tomcircuit/hp10544-retrofit/media/installed.JPG

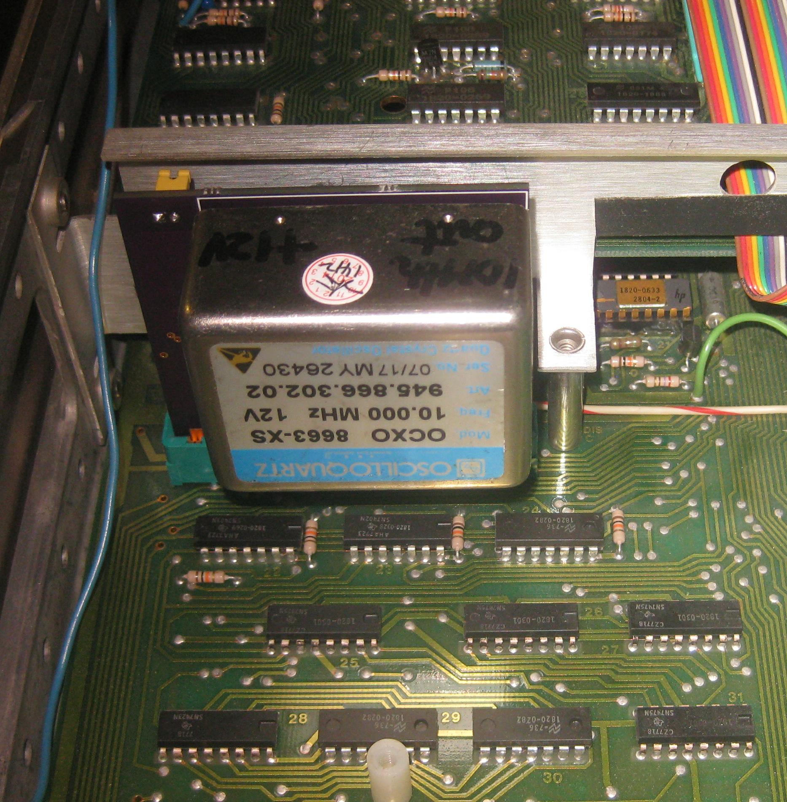
media/installed.JPG
