tomcircuit/hp10544-retrofit/media/installed rear.JPG

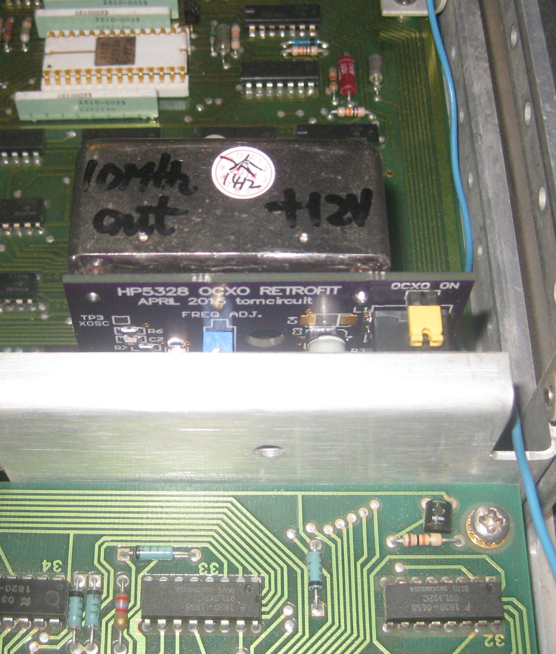
media/installed rear.JPG
