tomcircuit/hp10544-retrofit/media/front view.JPG

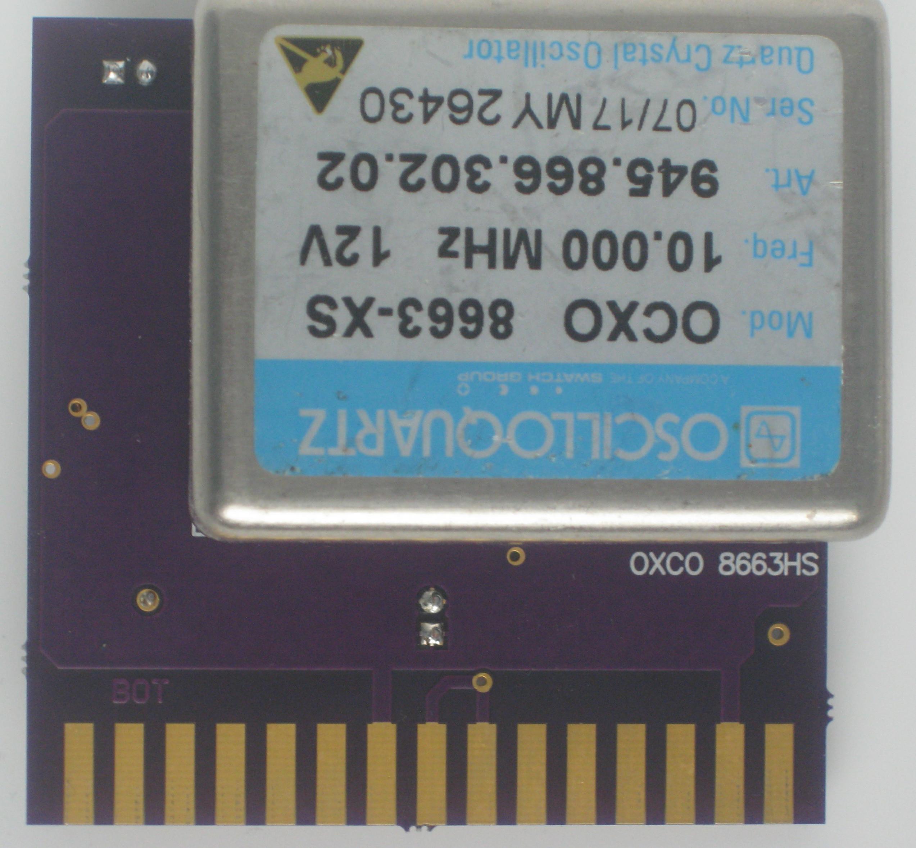
media/front view.JPG
