tomcircuit/hp10544-retrofit/media/hp5328 OCXO bay.JPG

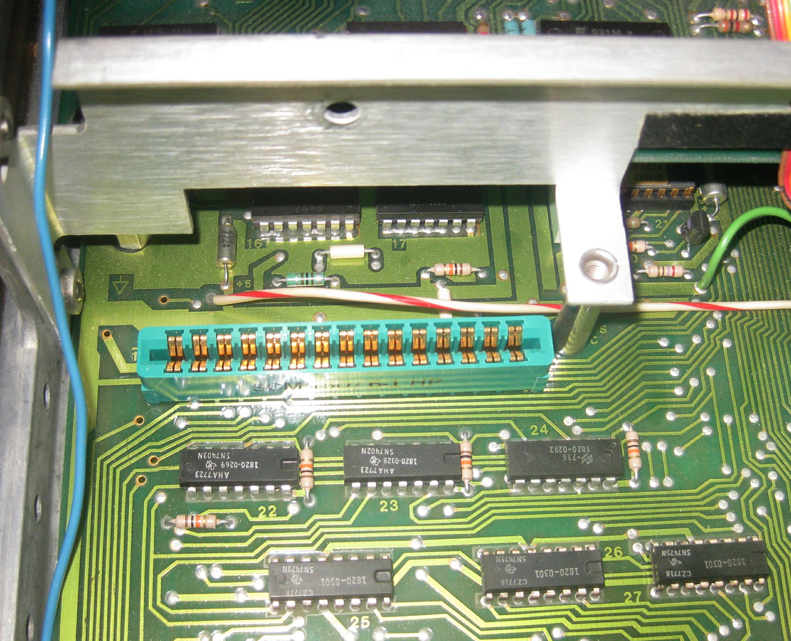
media/hp5328 OCXO bay.JPG
