tomcircuit/hp10544-retrofit/media/isntalled front.JPG

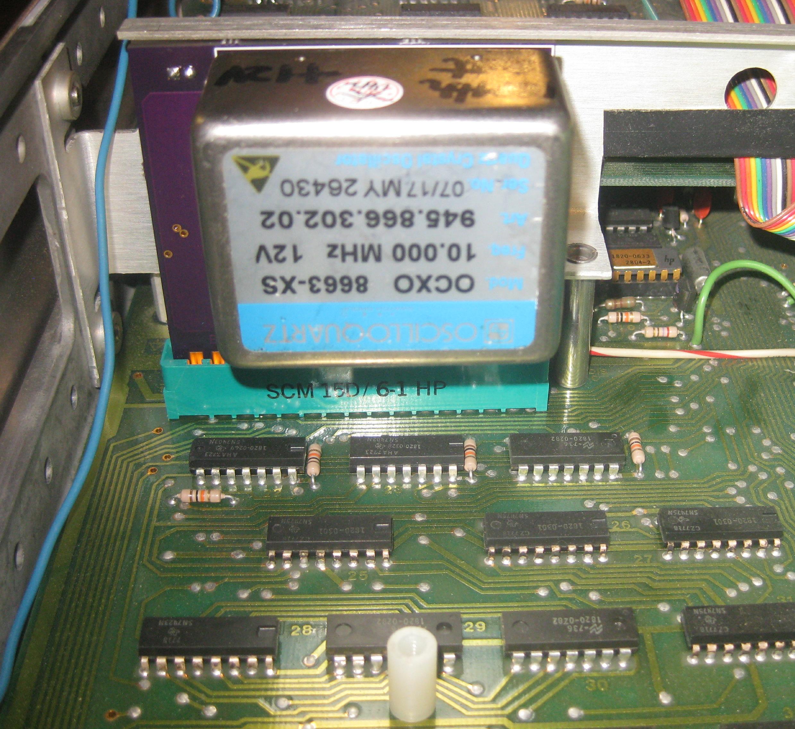
media/isntalled front.JPG
