tomcircuit/hp10544-retrofit/media/rear view.JPG

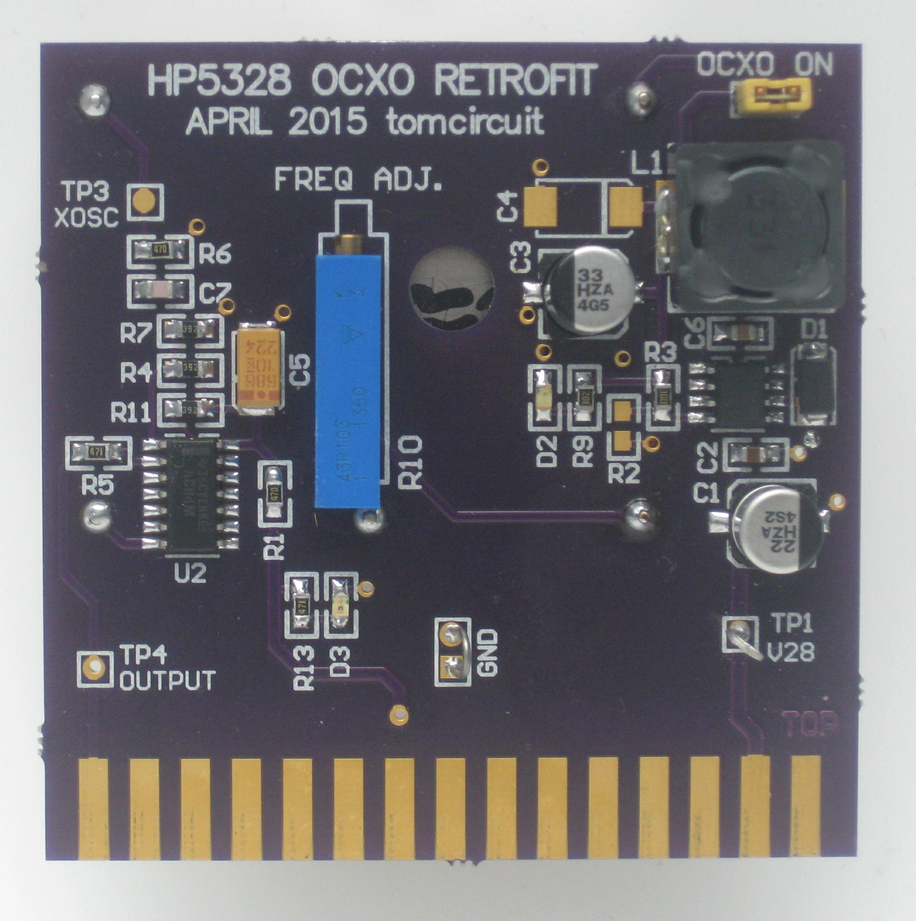
media/rear view.JPG
