tomcircuit/hp10544-retrofit/media/side view.JPG

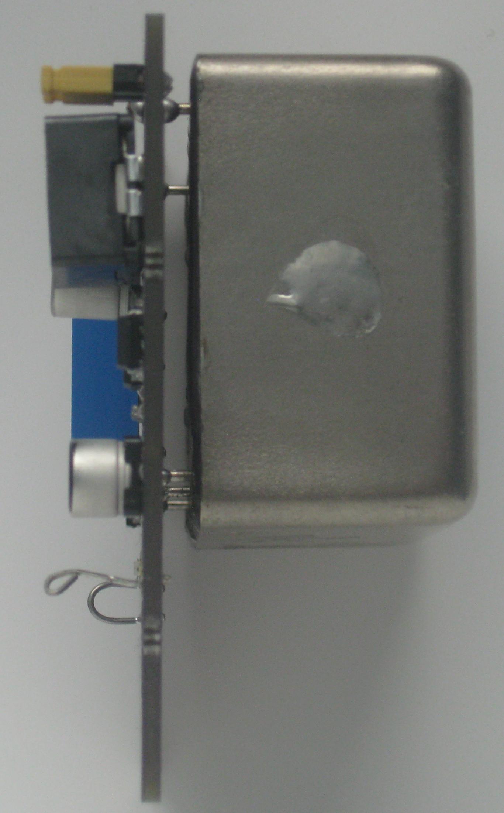
media/side view.JPG
