tomcircuit/hp10544-retrofit/media/installed side.JPG

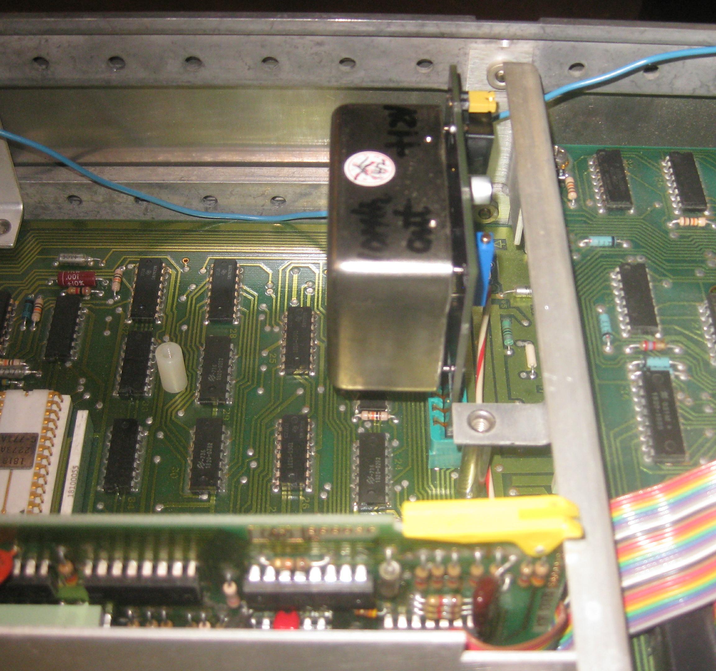
media/installed side.JPG
