tomcircuit/hp10544-retrofit/replacement_osc_sch_updated2021.pdf

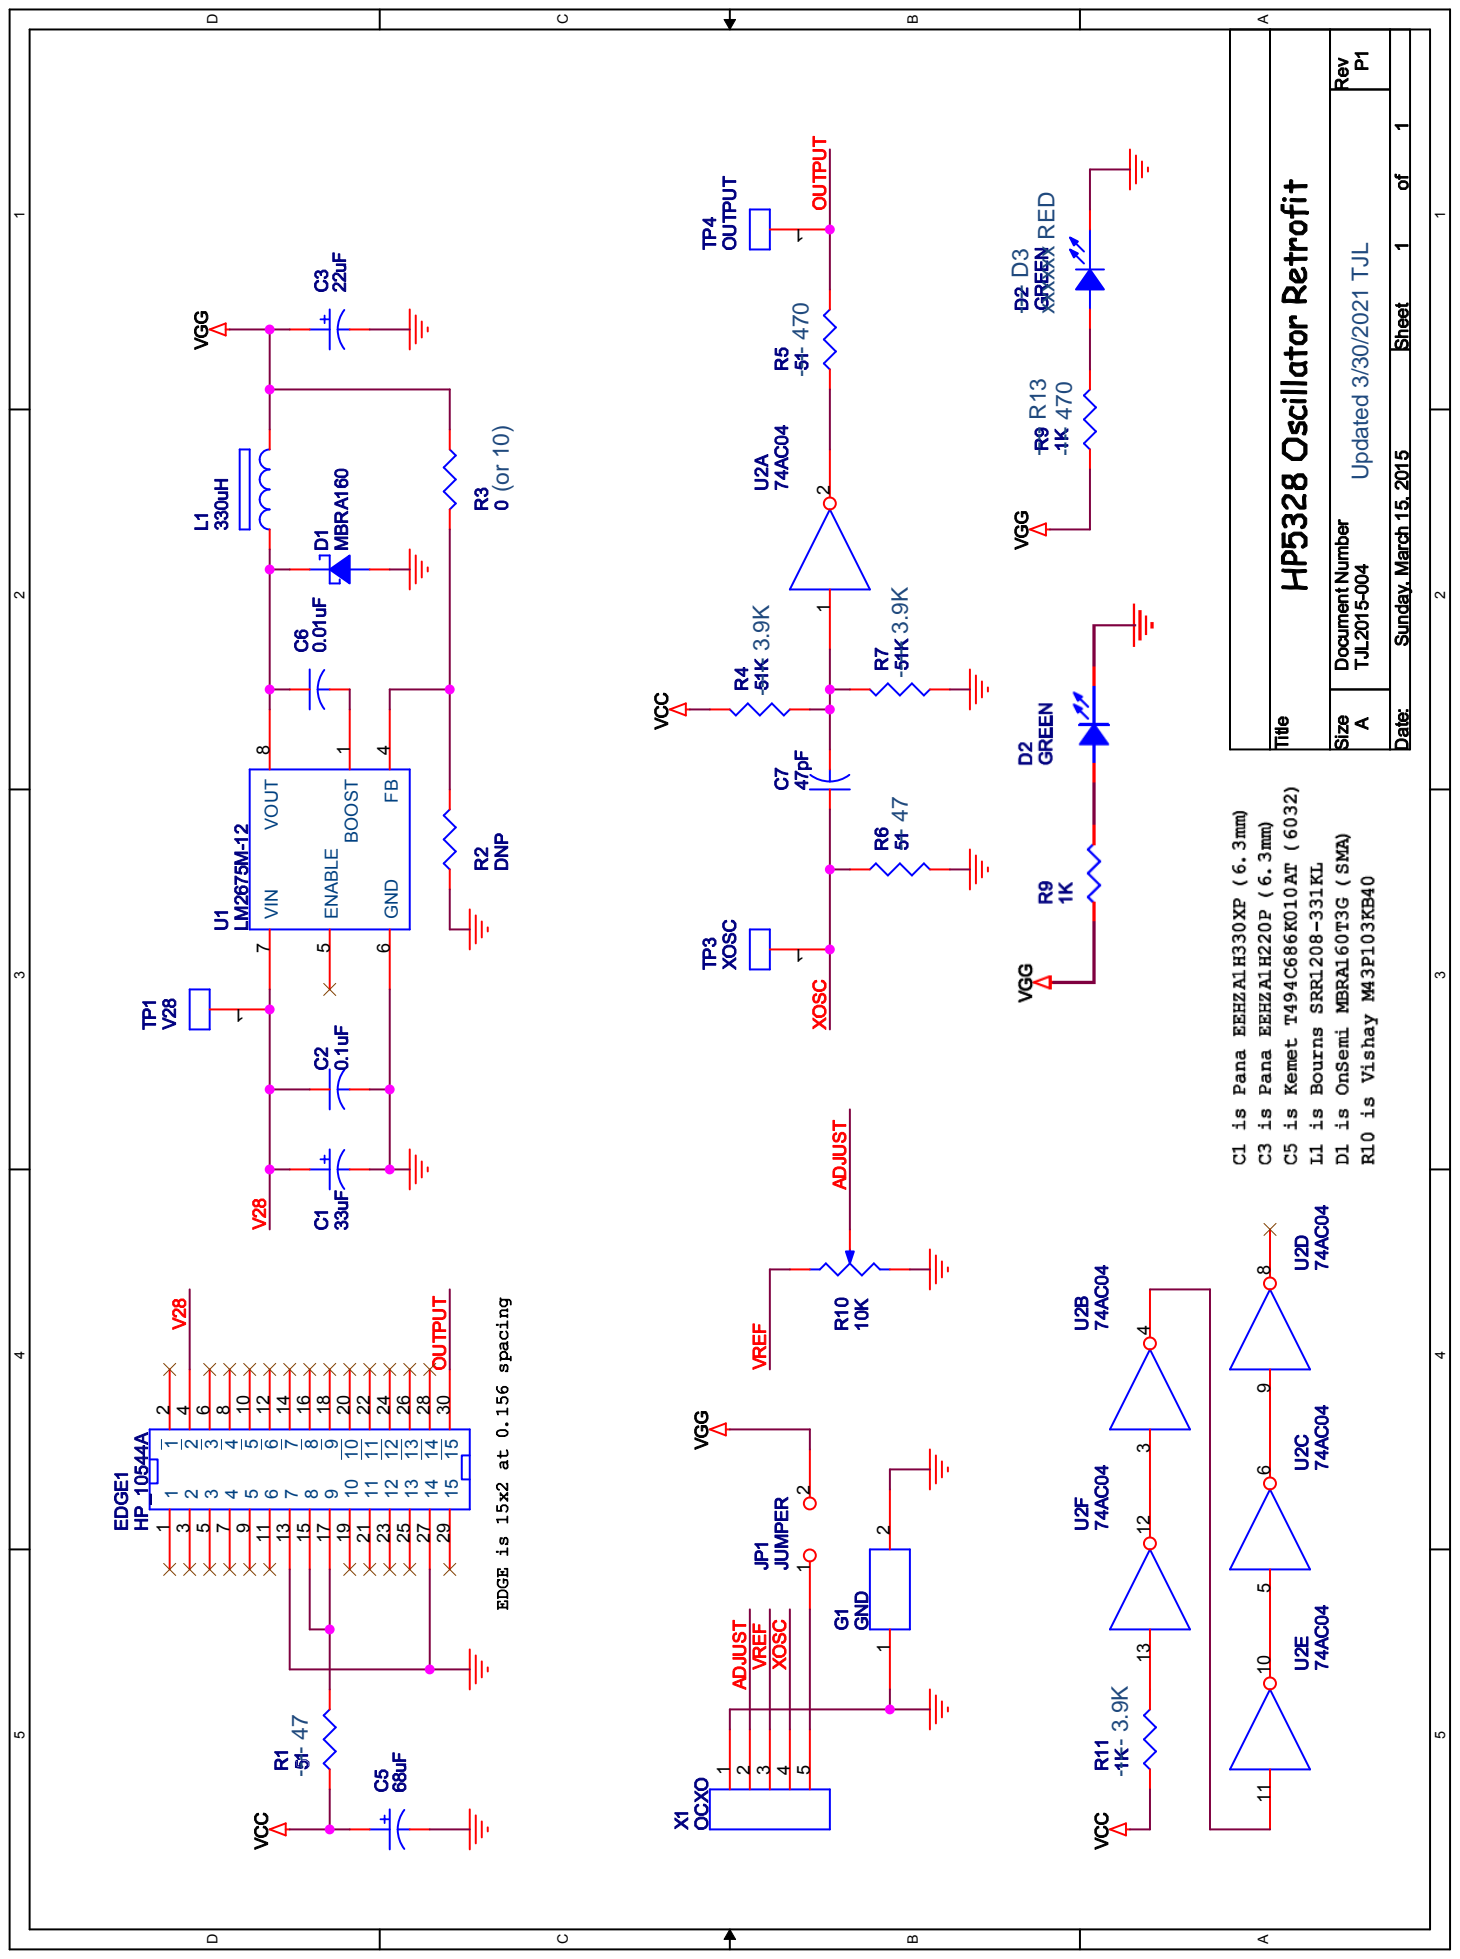
[picture p9: page 1]
VIN; ENABLE; GND; BOOST; VOUT; xxxxxx RED; Updated 3/30/2021 TJL
