tomcircuit/hp10544-retrofit/(list of files, drawings)

Other design files:
schematic/REPLACEMENT_OSC.DSN
schematic/replacement_osc.opj
