tomcircuit/hp10544-retrofit/(commit log)

2015-06-13 Initial Load
    Updated readme file. Added PCB, Schematic, and Media dirs and files.
    [REPLACEMENT_OSC.DSN, replacement_osc.opj]
2021-03-30 Updated Schematic File
    The schematic PDF file has incorrect component values - I examined the physical board and corrected the values on the schematic. I also added D3/R13 components to the schematic, which provide LED indication for +5V from edge connector.
